vd141/AM-Transmitter-Project/Modulator/IMG_6568.JPG

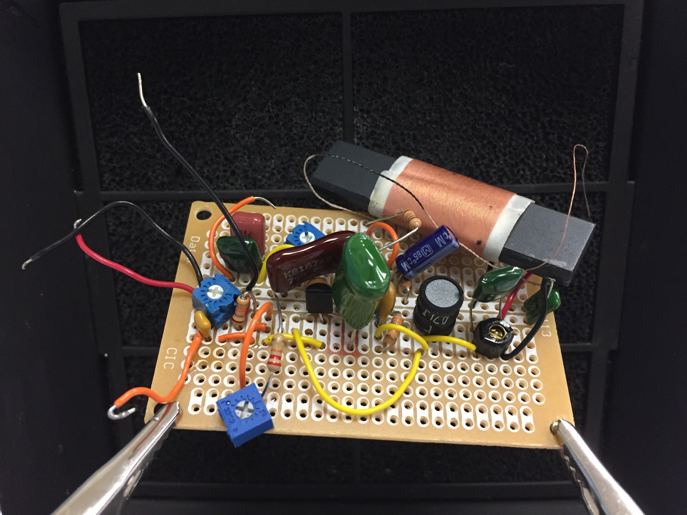
Modulator/IMG_6568.JPG
