vd141/AM-Transmitter-Project/Colpitts Oscillator/IMG_6567.JPG

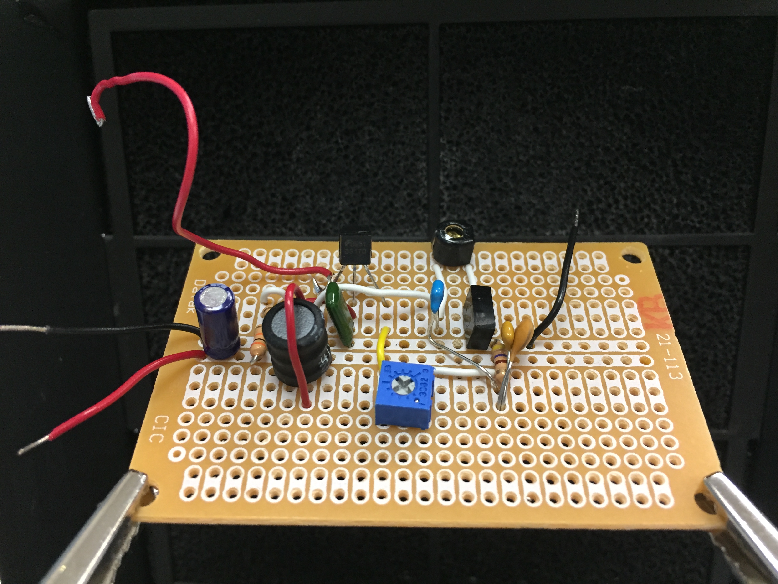
Colpitts Oscillator/IMG_6567.JPG
