vd141/AM-Transmitter-Project/audioSignal.jpg

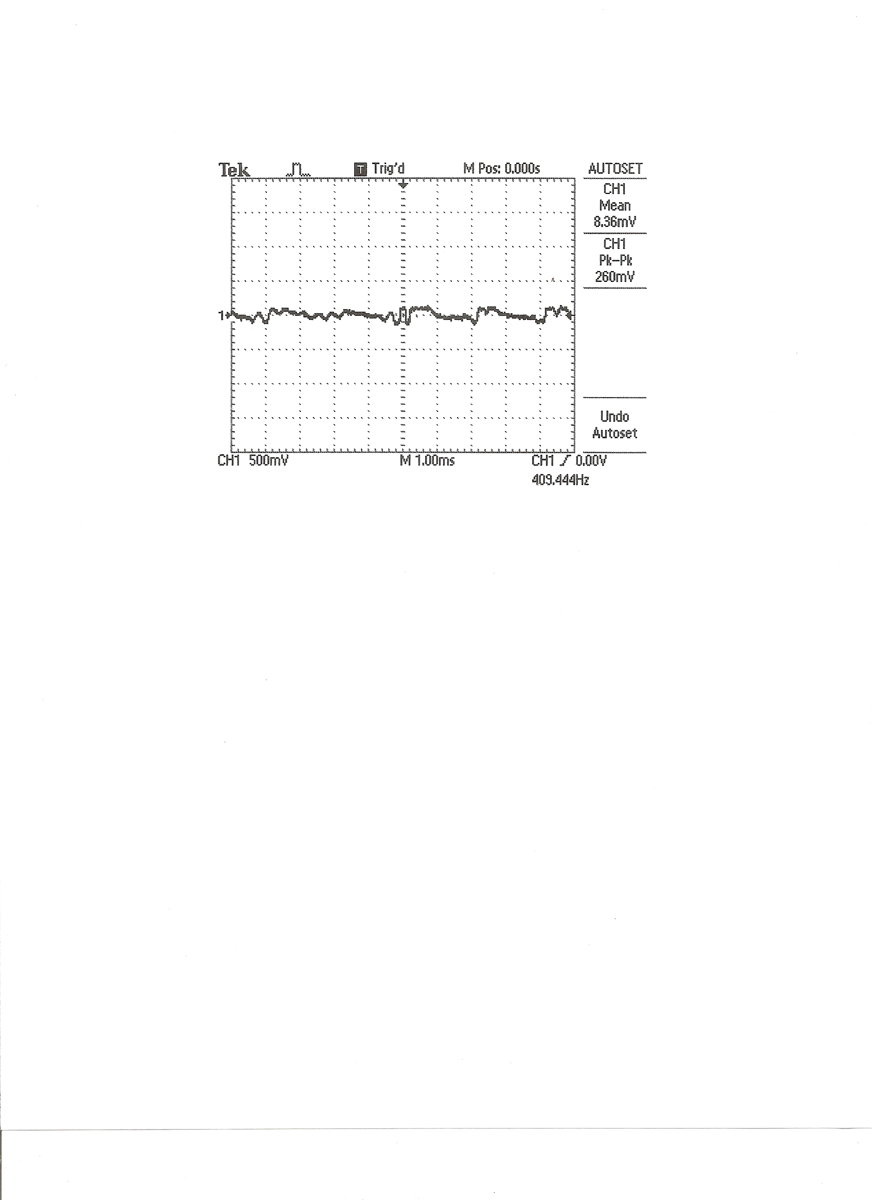
audioSignal.jpg
