vd141/AM-Transmitter-Project/Colpitts Oscillator/oscillatorFFT.PNG

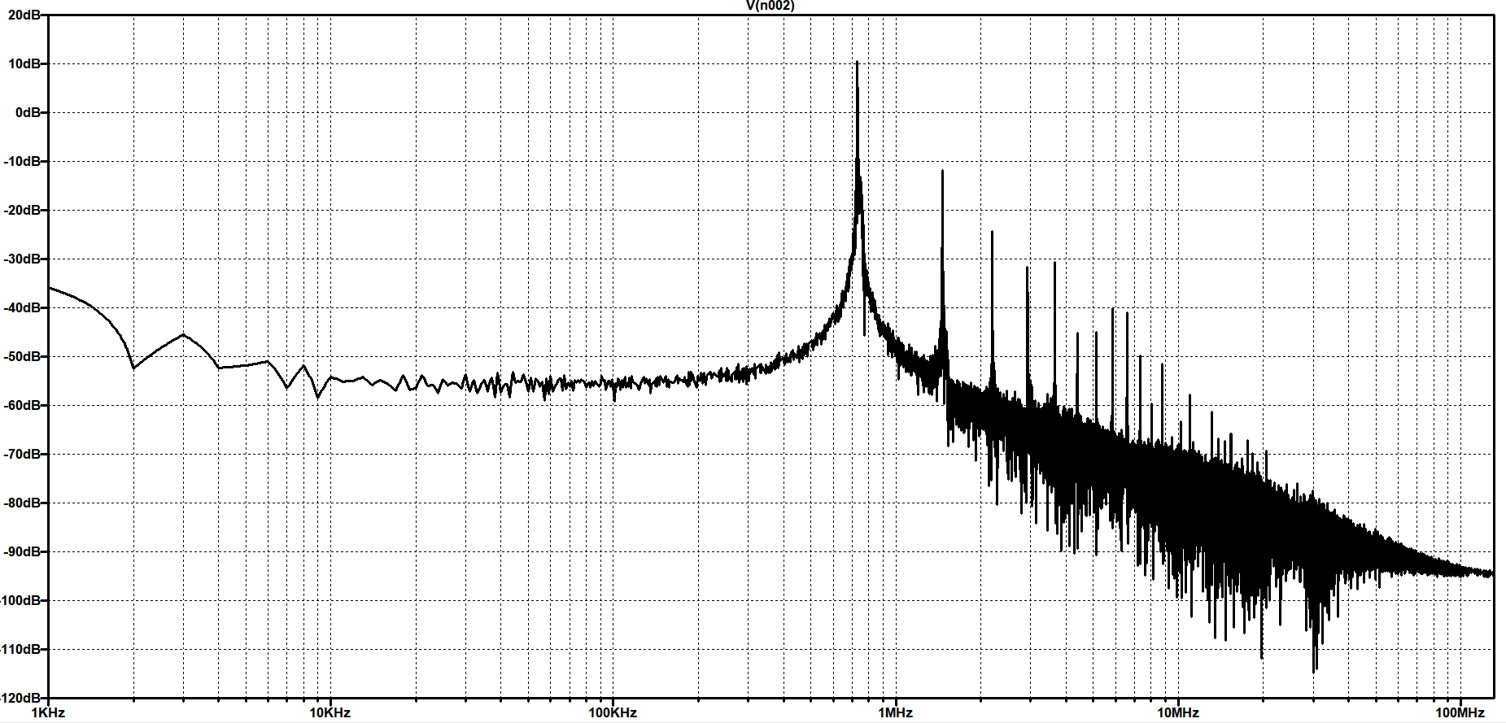
Colpitts Oscillator/oscillatorFFT.PNG
