vd141/AM-Transmitter-Project/Colpitts Oscillator/oscillatorOutput.PNG

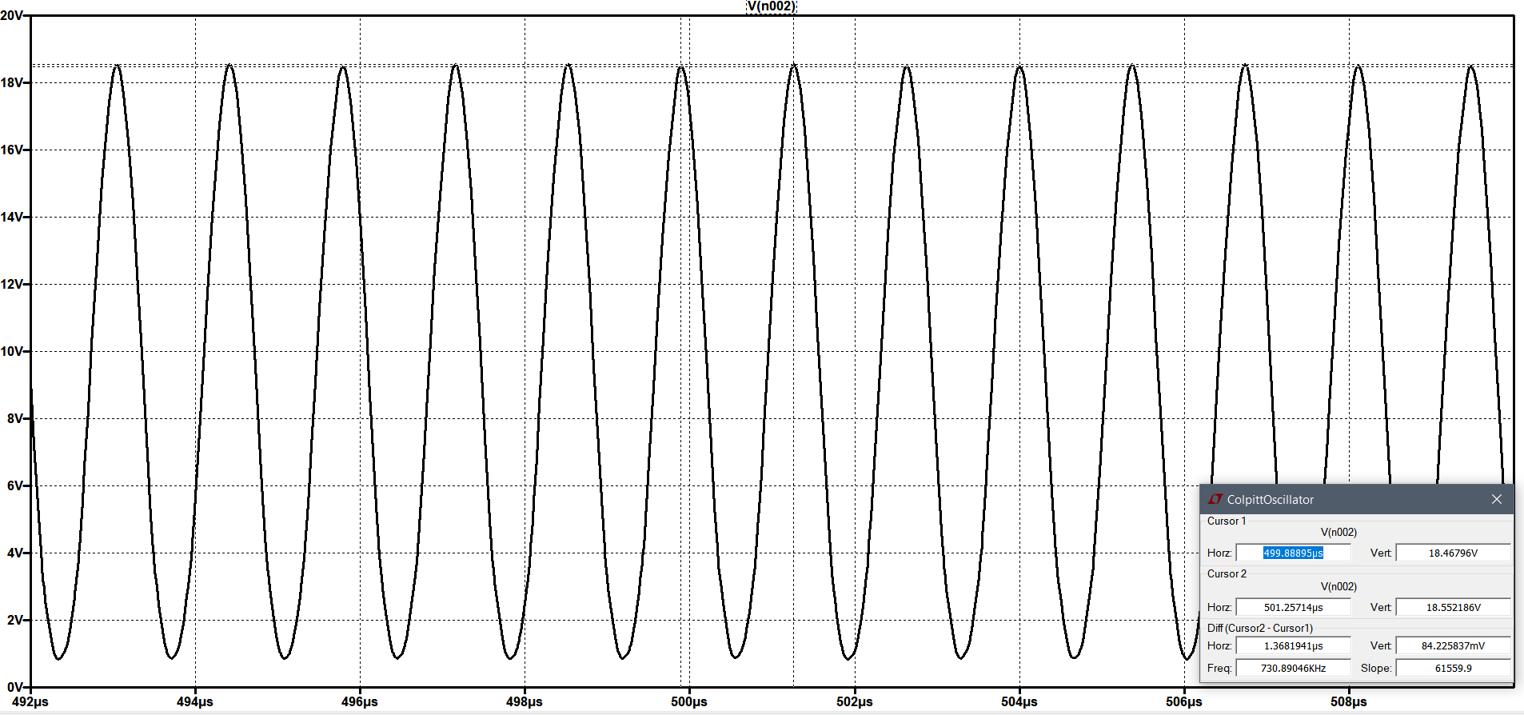
Colpitts Oscillator/oscillatorOutput.PNG
