vd141/AM-Transmitter-Project/Colpitts Oscillator/oscillatorPic.PNG

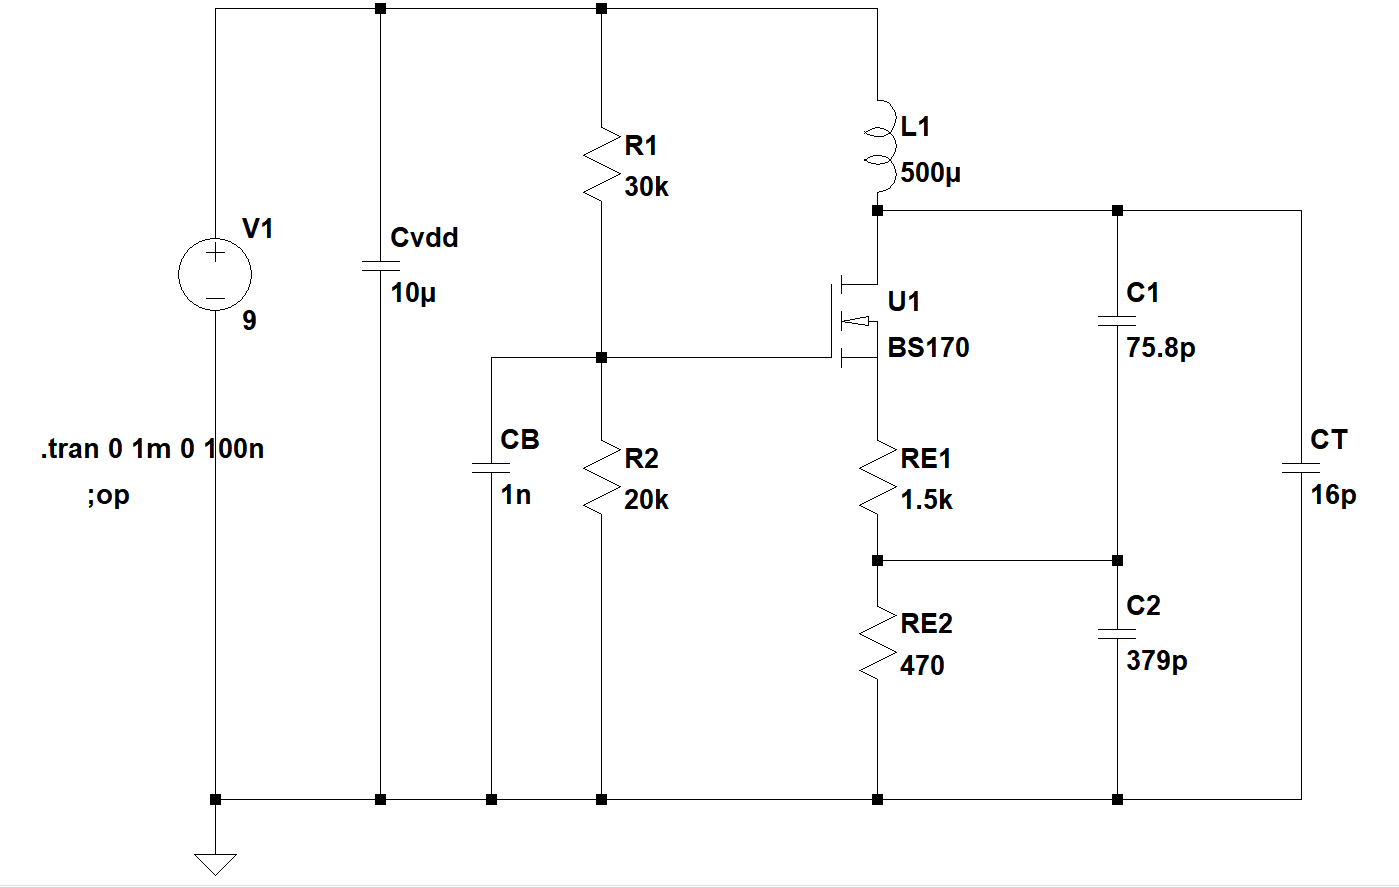
Colpitts Oscillator/oscillatorPic.PNG
