vd141/AM-Transmitter-Project/Modulator/modulatorPic.PNG

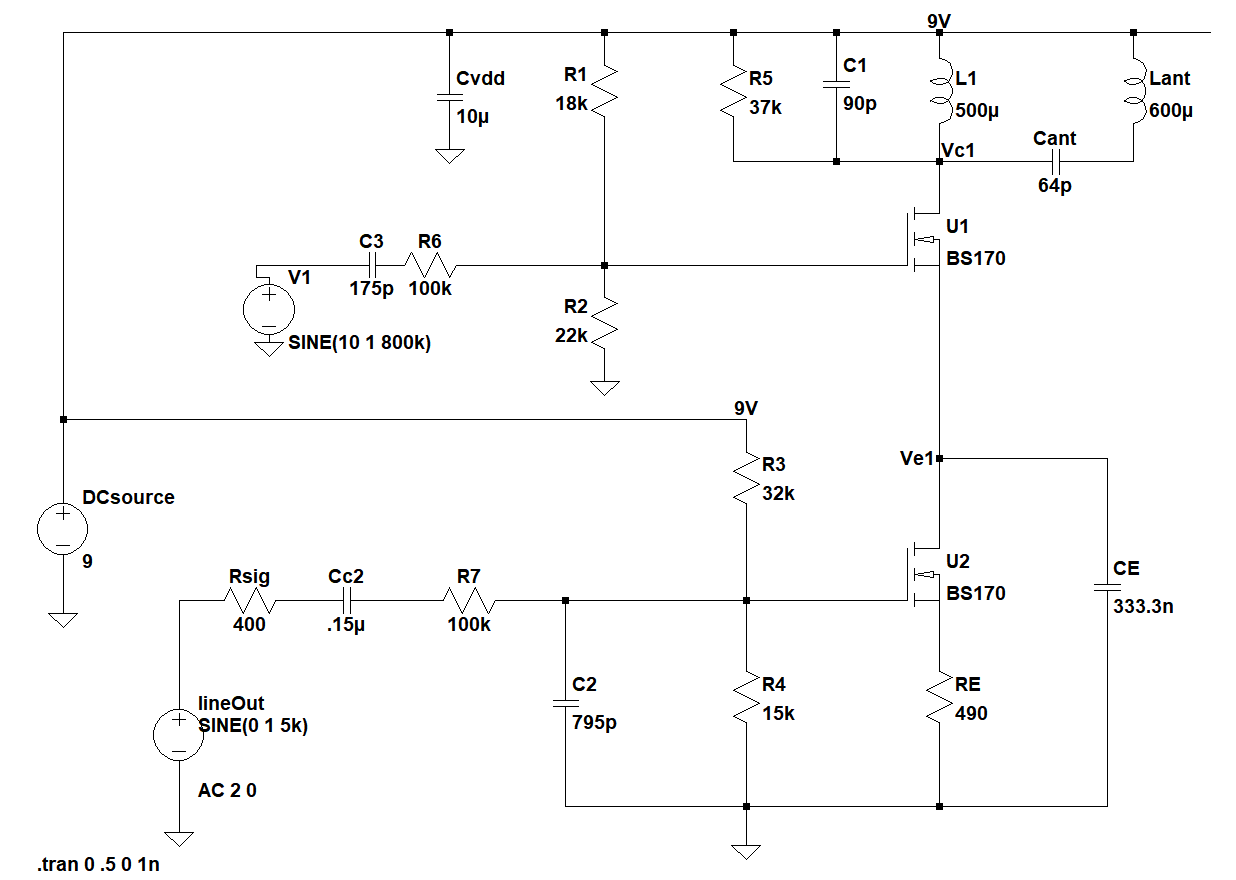
Modulator/modulatorPic.PNG
