vd141/AM-Transmitter-Project/Modulator/modulatorSignal.PNG

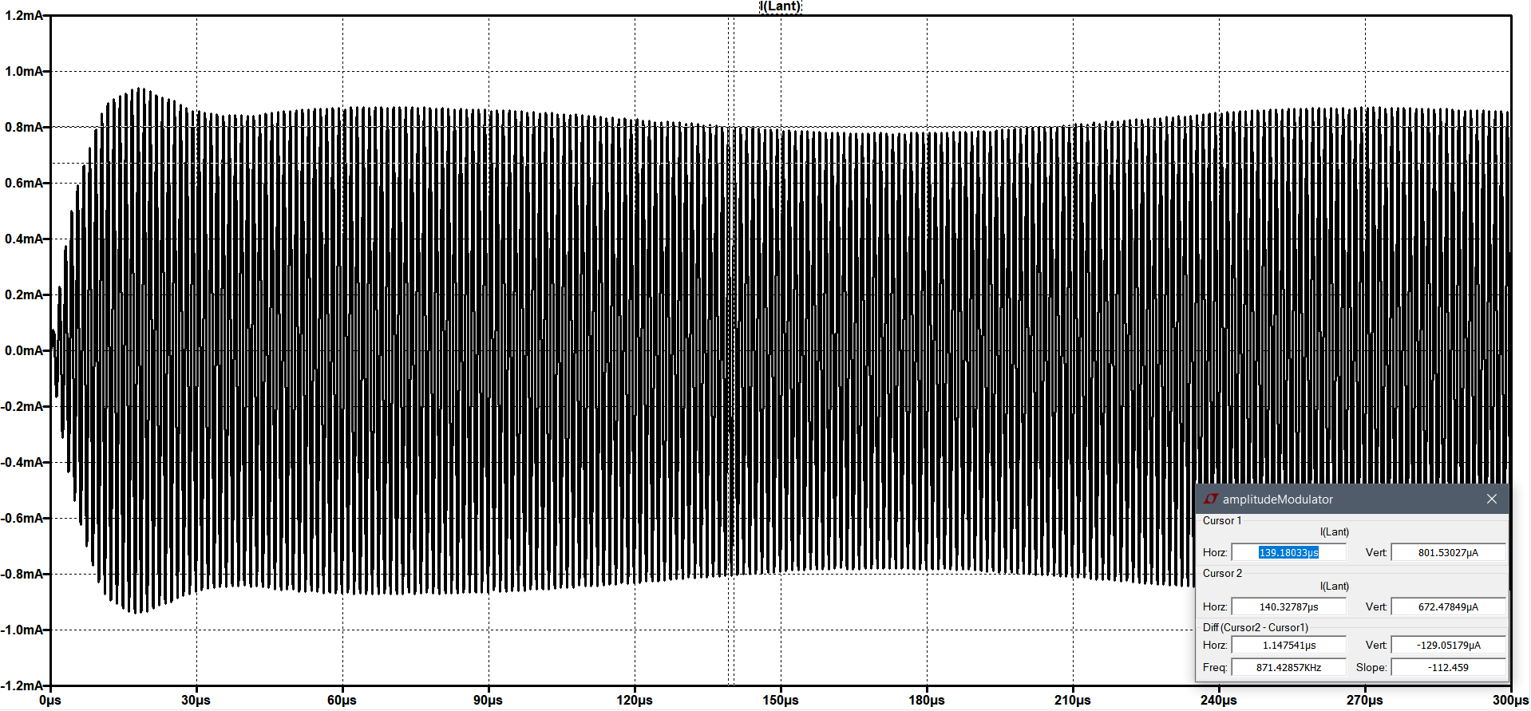
Modulator/modulatorSignal.PNG
