vd141/AM-Transmitter-Project/oscillatorFFT.jpg

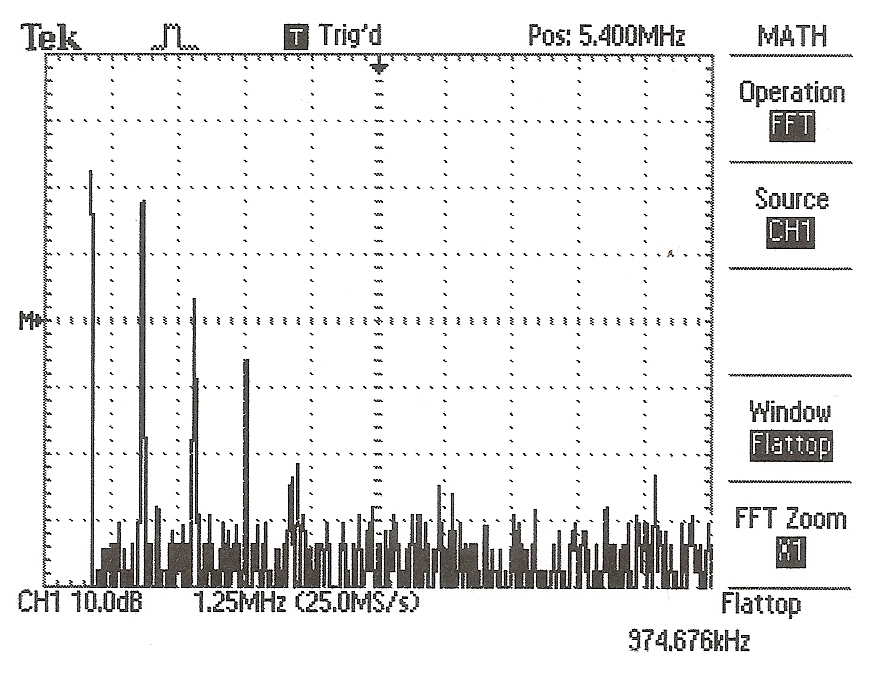
oscillatorFFT.jpg
