vd141/AM-Transmitter-Project/oscillatorOutput.jpg

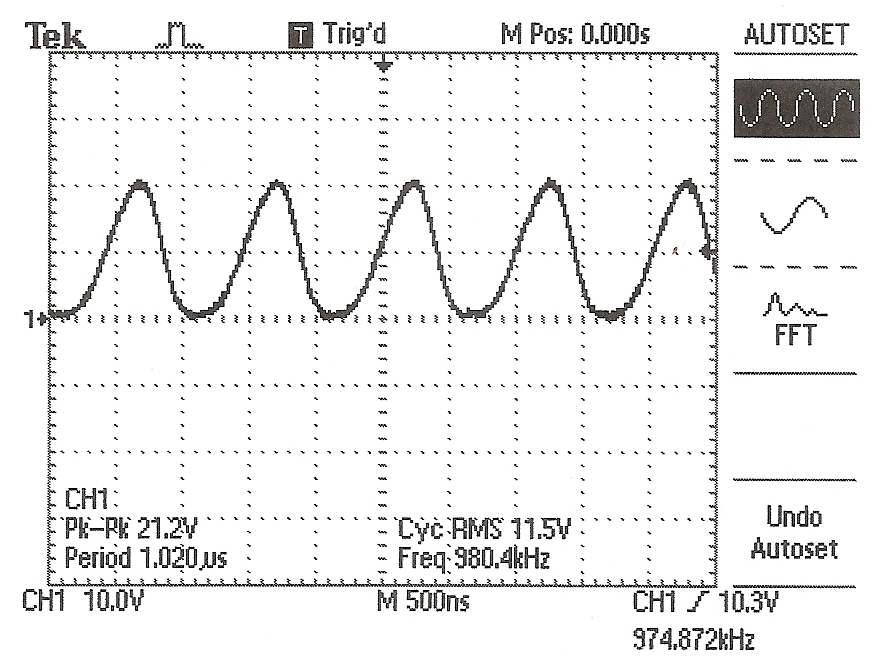
oscillatorOutput.jpg
