vd141/AM-Transmitter-Project/amplitudeModulator.asc

C1: cap; 90p
C2: cap; 795p
C3: cap; 175p
Cant: cap; 64p
Cc2: cap; .15µ
CE: cap; 333.3n
Cvdd: cap; 10µ
DCsource: voltage; 9
L1: ind; 500µ
Lant: ind; 600µ
lineOut: voltage; SINE(0 1 5k); AC 2 0
R1: res; 18k
R2: res; 22k
R3: res; 32k
R4: res; 15k
R5: res; 37k
R6: res; 100k
R7: res; 100k
RE: res; 490
Rsig: res; 400
U1: BS170
U2: BS170
V1: voltage; SINE(10 1 800k)
Named nets: 0, Vc1, 9V, Ve1
.tran 0 .5 0 1n
