vd141/AM-Transmitter-Project/ColpittOscillator.asc

C1: cap; 75.8p
C2: cap; 379p
CB: cap; 1n
CT: cap; 16p
Cvdd: cap; 10µ
L1: ind; 500µ
R1: res; 30k
R2: res; 20k
RE1: res; 1.5k
RE2: res; 470
U1: BS170
V1: voltage; 9
Named nets: 0
;op
.tran 0 1m 0 100n
